carvalhorod09-beep/Targeting-Turret/docs/schematic.jpg

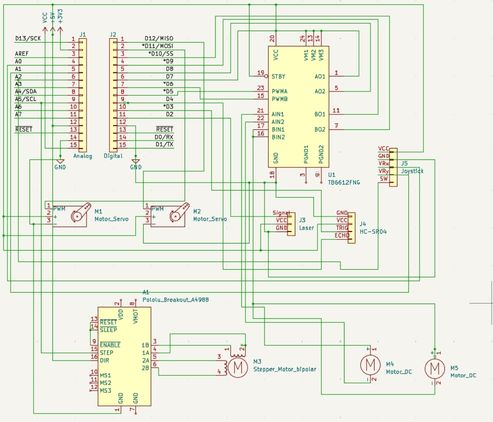
docs/schematic.jpg
