carvalhorod09-beep/Targeting-Turret/docs/turret.jpg

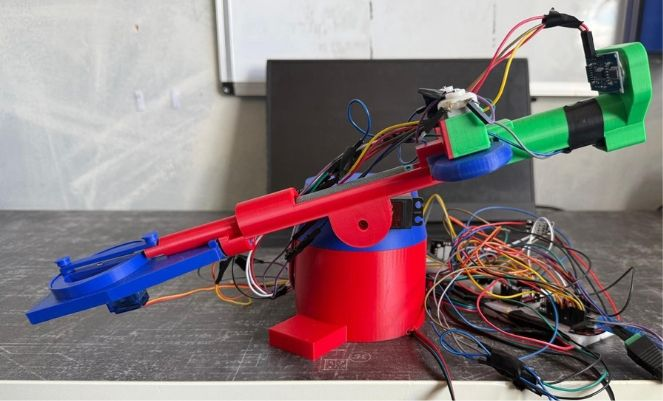
docs/turret.jpg
