carvalhorod09-beep/Targeting-Turret/docs/derivations/sensorGeometry.jpg

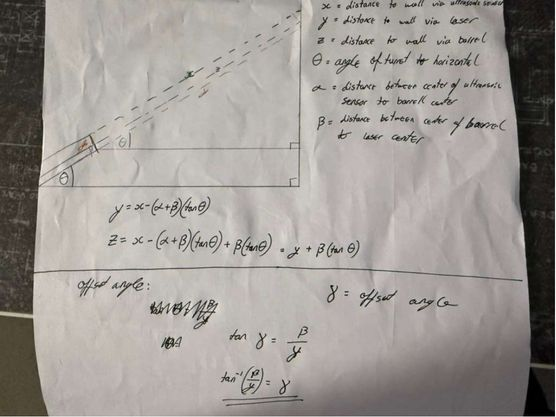
docs/derivations/sensorGeometry.jpg
