carvalhorod09-beep/Targeting-Turret/docs/derivations/SUVATCalcs.jpg

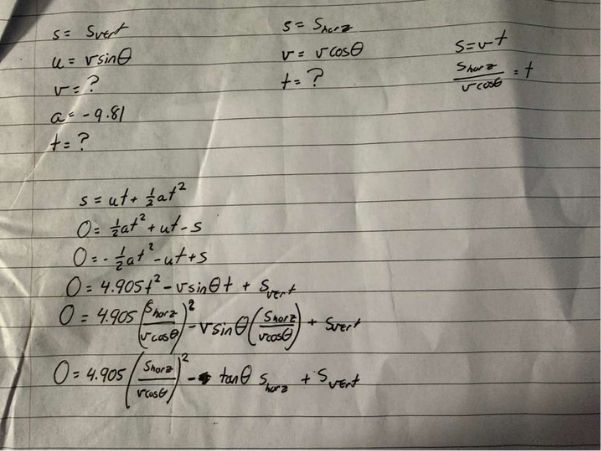
docs/derivations/SUVATCalcs.jpg
