carvalhorod09-beep/Targeting-Turret/docs/data/Results.csv

Horizontal Displacement (m) | Vertical Displacement (m) | Displacement (m) | Low angle (deg) | High angle (deg) | Horizontal Displacement (m) | Vertical Displacement (m) | Displacement (m) | Low angle (deg) | High angle (deg)
1 | 0.5 | 1.12 | 27.55 | 89.01 | 0.5 | 1 | 1.12 | 63.93 | 89.50
2 | 0.5 | 2.06 | 16.02 | 88.02 | 0.5 | 2 | 2.06 | 76.47 | 89.49
3 | 0.5 | 3.04 | 12.43 | 87.03 | 0.5 | 3 | 3.04 | 81.06 | 89.48
4 | 0.5 | 4.03 | 11.09 | 86.03 | 0.5 | 4 | 4.03 | 83.40 | 89.47
5 | 0.5 | 5.02 | 10.68 | 85.03 | 0.5 | 5 | 5.02 | 84.83 | 89.46
6 | 0.5 | 6.02 | 10.74 | 84.02 | 0.5 | 6 | 6.02 | 85.79 | 89.45
7 | 0.5 | 7.02 | 11.08 | 83.01 | 0.5 | 7 | 7.02 | 86.48 | 89.43
Trials | Horizontal Displacement (m) | Vertical Displacement (m) | Vertical Offset (m)
1 | 1 | 0.50 | 0.03
 | 2 | 0.50 | 0.005
 | 3 | 0.50 | -0.02
 | 4 | 0.50 | -0.03
2 | 1 | 0.50 | 0.01
 | 2 | 0.50 | -0.04
 | 3 | 0.50 | -0.02
 | 4 | 0.50 | -0.03
3 | 1 | 0.50 | 0.005
 | 2 | 0.50 | -0.02
 | 3 | 0.50 | 0.015
 | 4 | 0.50 | -0.02
4 | 1 | 0.50 | 0.02
 | 2 | 0.50 | -0.04
 | 3 | 0.50 | -0.001
 | 4 | 0.50 | -0.07
5 | 1 | 0.50 | 0
 | 2 | 0.50 | -0.03
 | 3 | 0.50 | 0.05
 | 4 | 0.50 | -0.01
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
