carvalhorod09-beep/Targeting-Turret/(commit log)

2026-10-25 Revise README with updated links and hardware details
    Updated demo video and turret photo locations, specified Arduino model, and corrected schematic file format.
2026-10-25 Rename Untitled spreadsheet - Sheet1.csv to Results.csv
    [Results.csv]
